MohammedAshikM3003/Cynexis/Esp32 Pins/WhatsApp Image 2026-10-05 at 19.05.23.jpeg

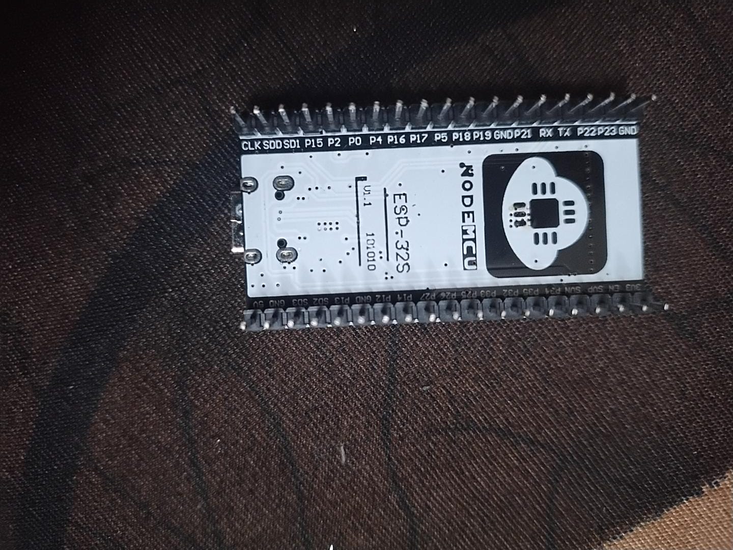
Esp32 Pins/WhatsApp Image 2026-10-05 at 19.05.23.jpeg
