MohammedAshikM3003/Cynexis/intro video/1bd78f29-dfb3-4b49-ac60-cee5ba025ea2.jpg

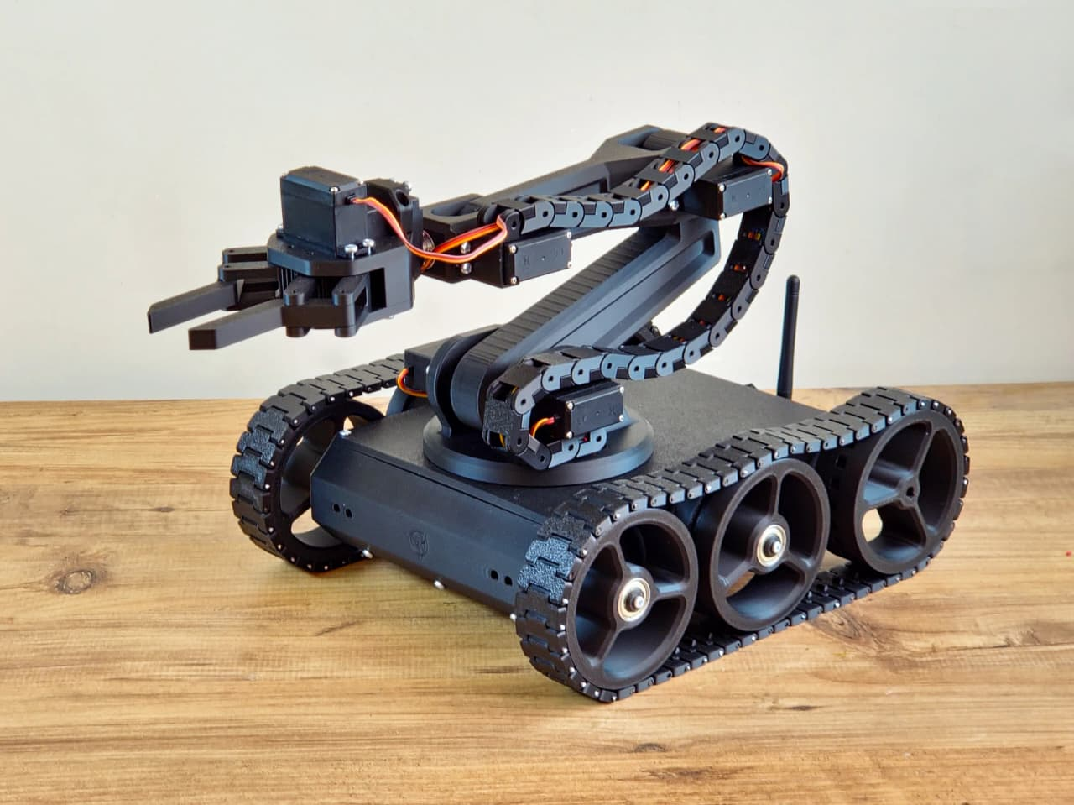
intro video/1bd78f29-dfb3-4b49-ac60-cee5ba025ea2.jpg
