MohammedAshikM3003/Cynexis/CYNEXIS_MASTER_SPECIFICATION.md

# CYNEXIS — Master Specification v2.1
> **Single Source of Truth. Do not contradict this document.**
> Version: 2.1 | Date: 2026-08-04 | Status: Active | Engineer: Mohammed Ashik M

---

## 1. PROJECT IDENTITY

| Field | Value |
|---|---|
| **Name** | CYNEXIS |
| **Tagline** | Connecting Human Intelligence with Machine Precision |
| **Version** | 2.1 (specification) / 1.0 (build) |
| **Type** | AI-Powered Gesture-Controlled Robotic Platform |
| **Status** | Phase 0 Complete — Phase 1 Starting |

---

## 2. WHAT WAS REMOVED (V1 → V2)

These features existed in the old concept. They are **permanently removed**.

| Feature | Reason |
|---|---|
| **Standalone voice-control mode** | Removed — no keyword-trigger-only commands |
| Holographic module | Out of scope |
| MongoDB | Replaced by SQLite + ChromaDB |
| MQTT | Replaced by ESP-NOW + Wi-Fi |
| TensorFlow | Replaced by PyTorch + YOLOv8 |

> **Clarification:** *AI-assisted voice interaction is retained.* The INMP441 microphone, MAX98357A amplifier, and speaker are part of the status glove and support two-way AI conversation. What is removed is the old standalone voice-command-only control mode from V1.

> **Rule:** Do not re-add any of these without a critical engineering justification.

---

## 3. SYSTEM ARCHITECTURE

```
                    LAPTOP AI CORE
                          │
              OpenCV + YOLO + MediaPipe
              PyTorch + FastAPI + ChromaDB
                          │
                        Wi-Fi
                          │
        ┌─────────────────┴─────────────────┐
        │                                   │
  CONTROL GLOVE                       ROBOT ESP32
        │                                   │
     ESP-NOW                           BTS7960
        │                              PCA9685
  5x Flex sensors                    4x DC motors
  MPU6050 IMU                        4x DS3218 servos
  ESP32                              HC-SR04
                                     Voltage sensor
                                     E-stop
        └─────────────────┬─────────────────┘
                          │ ESP-NOW
                    STATUS GLOVE
                          │
                    CYNEXIS OS
                          │
              3.5" Capacitive touchscreen
              INMP441 microphone
              MAX98357A + speaker
              Vibration motor
              ESP32
```

---

## 4. BILL OF MATERIALS (v2.0 OFFICIAL)

### 4.1 Control Glove

| ID | Component | Qty | Specs |
|----|---|-----|---|
| CG01 | ESP32 Dev Module | 1 | 38-pin WROOM-32 |
| CG02 | Flex Sensor 2.2" | 5 | 10k-110k Ω |
| CG03 | MPU6050 IMU | 1 | I2C, 3.3V |
| CG04 | 18650 Li-ion Cell | 1-2 | 2500-3500 mAh |
| CG05 | TP4056 Type-C Module | 1 | 1A, with protection |
| CG06 | Power Switch SPST | 1 | ≥5A rated |
| CG07 | Cotton Glove | 1 | Size L |

### 4.2 Status Glove

> **Two-stage build. Do not attempt Stage B until Stage A is fully tested.**

#### Stage A — Build First

| ID | Component | Qty | Specs |
|----|---|-----|---|
| SG01 | ESP32 Dev Module | 1 | 38-pin WROOM-32 |
| SG02 | 3.5" Capacitive Touchscreen | 1 | ILI9488 or similar, SPI |
| SG03 | Vibration Motor | 1 | 3V coin-type |
| SG04 | 2N2222 Transistor | 1 | NPN, TO-92 (for motor drive) |
| SG05 | 18650 Li-ion Cell | 1-2 | 2500-3500 mAh |
| SG06 | TP4056 Type-C Module | 1 | 1A, with protection |
| SG07 | Power Switch SPST | 1 | ≥5A rated |
| SG08 | Cotton Glove | 1 | Size L |

**Stage A goal:** CYNEXIS OS boots, touchscreen responds, vibration feedback works, ESP-NOW link active.

#### Stage B — Add After Stage A Complete

| ID | Component | Qty | Specs |
|----|---|-----|---|
| SG09 | INMP441 Microphone | 1 | I2S, 3.3V |
| SG10 | MAX98357A Amplifier | 1 | I2S, 3W |
| SG11 | Speaker | 1 | 3W, 4Ω or 8Ω |

**Stage B goal:** AI voice interaction, waveform display, audio feedback active.

### 4.3 Robot Platform

| ID | Component | Qty | Specs |
|----|---|-----|---|
| RB01 | ESP32 Dev Module | 1 | 38-pin WROOM-32 |
| RB02 | BTS7960 Motor Driver | 1 | 43A peak, 12V |
| RB03 | PCA9685 Servo Driver | 1 | 16-ch, I2C, 50Hz |
| RB04 | DC Gear Motor 12V | 4 | 150-300 RPM, metal gear |
| RB05 | DS3218 Servo Motor | 4 | 20kg-cm, 270° |
| RB06 | HC-SR04 Ultrasonic | 1 | 2-400cm |
| RB07 | Aluminium 4WD Chassis | 1 | Full kit |
| RB08 | 4-DOF Aluminium Arm | 1 | Compatible with DS3218 |
| RB09 | 18650 Li-ion Cell | 3 | 3S pack, 2500-3500 mAh |
| RB10 | BMS 3S | 1 | 10A, overcharge protection |
| RB11 | LM2596 Buck Converter | 2 | Adjustable, 3A |
| RB12 | XT60 Connector | 2 | Male + Female pair |
| RB13 | 10A Fuse + Holder | 1 | Inline blade type |
| RB14 | E-stop Button | 1 | NC momentary, red |
| RB15 | Power Switch | 1 | SPST ≥5A |
| RB16 | Heatsink | 2 | For BTS7960 + LM2596 |
| RB17 | TVS Diode 15V | 2 | DO-15 |
| RB18 | 1N4007 Diode | 10 | Flyback protection |
| RB19 | 1000µF 25V Capacitor | 4 | Electrolytic |
| RB20 | 470µF 16V Capacitor | 4 | Electrolytic |
| RB21 | INA219 Current/Voltage Sensor | 1 | I2C, measures current + power + battery runtime |

### 4.4 Vision System

| ID | Component | Qty | Specs |
|----|---|-----|---|
| VS01 | Dedicated Camera Module | 1 | 1080p, low-latency stream, compact rover front mount |
| VS02 | White LED Illumination | 1-2 | Software-controllable front LED flash/light |

### 4.5 Prototyping (shared)

| ID | Component | Qty |
|----|---|-----|
| PR01 | Breadboard (full size) | 2 |
| PR02 | Jumper wire sets (M-M, M-F, F-F) | 3 sets |
| PR03 | Resistor kit (assorted, incl. 10kΩ) | 1 kit |
| PR04 | Capacitor kit (assorted) | 1 kit |
| PR05 | LED pack | 1 pack |
| PR06 | 2N2222 NPN transistor | 4 |
| PR07 | Male header pins | 2 packs |
| PR08 | Female header pins | 2 packs |
| PR09 | Heat-shrink tubing | 1 pack |
| PR10 | Electrical tape | 1 roll |
| PR11 | Zip ties | 1 pack |

> **Note on MG996R vs DS3218:** Architecture upgraded from MG996R (10kg-cm) to DS3218 (20kg-cm, 270°) for the robotic arm. DS3218 provides stronger hold and wider angle range.

---

## 5. CYNEXIS OS

### 5.1 Overview

CYNEXIS OS is a full graphical interface running on the status glove's 3.5" touchscreen. It is implemented using **LVGL** (Light and Versatile Graphics Library).

### 5.2 Screens

| Screen | Function |
|---|---|
| Boot screen | Animated CYNEXIS startup logo |
| Diagnostics | Real-time sensor health, battery, signal |
| AI Assistant | Voice + text AI interaction |
| Gesture Monitor | Live finger and IMU data display |
| Communication | ESP-NOW / Wi-Fi link status |
| Settings | Brightness, volume, thresholds |
| Camera | Live feed from robot camera |
| Arm Control | Manual servo position control |
| Battery Monitor | Voltage, current, runtime estimate |
| Sensor Monitor | All sensor values in real time |
| Audio Interface | Waveform, voice input, speaker |
| Notifications | Alerts, warnings, system messages |

### 5.3 UI Features

- Animated icons
- Dark mode
- Sliding menus
- Touch control (capacitive)
- Real-time telemetry overlay
- Waveform display
- Voice feedback via speaker

### 5.4 Implementation

- Library: **LVGL v9.x**
- Design tool: **Figma** (mockups)
- Target: ESP32 with ILI9488 3.5" display
- Communication to robot: ESP-NOW (status updates)
- Communication to laptop: Wi-Fi (AI assistant)

---

## 6. SOFTWARE STACK

### 6.1 Embedded

| Tool | Purpose |
|---|---|
| Arduino IDE 2.3.10 | Flashing, library management |
| PlatformIO v3.3.4 | Advanced build system |
| ESP-IDF | Low-level ESP32 APIs |
| FreeRTOS | Task scheduling on ESP32 |
| LVGL v9.x | CYNEXIS OS UI framework |

### 6.2 AI / Vision

| Library | Version | Purpose |
|---|---|---|
| Python | 3.12.10 | Runtime (venv at d:\Cynexis\.venv) |
| PyTorch | 2.13.0 | AI/ML framework |
| OpenCV | 5.0.0.93 | Computer vision |
| MediaPipe | 1.0.0 | Hand/pose tracking |
| Ultralytics (YOLOv8) | 8.4.115 | Object detection |
| DeepSORT | latest | Object tracking |

### 6.3 Backend

| Tool | Version | Purpose |
|---|---|---|
| FastAPI | 0.141.1 | REST API server |
| Uvicorn | 0.52.1 | ASGI server |
| WebSockets | 17.0.1 | Real-time data |

### 6.4 Frontend

| Tool | Purpose |
|---|---|
| React | Web dashboard |
| Figma | UI design and mockups |

### 6.5 Database / Memory

| System | Purpose |
|---|---|
| SQLite | Short-term memory, session context |
| ChromaDB | Long-term vector memory, retrieval |

---

## 7. COMMUNICATION ARCHITECTURE

| Link | Protocol | Speed | Notes |
|---|---|---|---|
| Control glove → Robot | ESP-NOW | ~50 Hz | <1ms latency, no router needed |
| Robot → Status glove | ESP-NOW | ~10 Hz | Status + ACK |
| Robot → Laptop | Wi-Fi | As needed | Telemetry + camera |
| Laptop → Robot | Wi-Fi | As needed | AI commands |

---

## 8. DEVELOPMENT PHASES

| Phase | Name | Key Deliverables |
|---|---|---|
| 0 | Environment Setup | ✅ Complete |
| 1 | Control Glove | Flex + IMU + ESP-NOW TX |
| 2 | Status Glove | OLED/Touch + CYNEXIS OS boot |
| 3 | Robot Base | Motors + BTS7960 + ESP-NOW RX |
| 4 | Robotic Arm | DS3218 servos + PCA9685 |
| 5 | Vision System | Camera + OpenCV + YOLOv8 |
| 6 | Audio System | INMP441 + MAX98357A + voice |
| 7 | CYNEXIS OS | Full LVGL UI on touchscreen |
| 8 | Full Integration | All systems unified + testing |

---

## 9. POWER ARCHITECTURE

### Robot (3S Li-ion, 11.1V)

```
3S Battery Pack (11.1V)
        │
      [BMS 10A]
        │
     [10A Fuse]
        │
   [Main Switch]
        │
        ├── [BTS7960] ──── 4× DC Motors (12V direct)
        │
        ├── [LM2596 #1] ── 6.5V ── [PCA9685 V+] ── 4× DS3218 servos
        │                   ↑
        │          (NOT 7.5V — reduces heating, improves reliability)
        │
        └── [LM2596 #2] ── 5V ─── [ESP32 VIN]
                                ├── [HC-SR04]
                                └── [PCA9685 VCC]
```

> **Servo voltage note:** DS3218 rated for 4.8V–8.4V. Running at 6.5V is the optimal point — high enough for torque, low enough to minimize heat and extend servo lifespan. Never exceed 7.5V under continuous load.

### Gloves (Single cell, 3.7V)

```
18650 Cell → [TP4056] → ESP32 + sensors
```

---

## 10. CAMERA & VISION SYSTEM ARCHITECTURE

### 10.1 Overview & Purpose
The camera system acts as the **visual sensor ("eyes") for the Cynexis Agent**, streaming live video, capturing photographs, uploading to cloud storage, and providing visual data to AI vision models (VLM) and the Cynexis Web Dashboard.

```
                    ┌──────────────────────────┐
                    │       CYNEXIS AGENT      │
                    │                          │
                    │  Vision / AI Processing  │
                    └────────────┬─────────────┘
                                 │
                         Commands / Analysis
                                 │
                                 ▼
┌────────────────────────────────────────────────────────────┐
│                     CYNEXIS ROVER                          │
│                                                            │
│   ┌──────────────┐       ┌─────────────────────────────┐  │
│   │ Camera       │──────▶│ Camera Controller           │  │
│   │ Module       │       │                             │  │
│   └──────────────┘       │ Capture / Stream / Control  │  │
│          │               └──────────────┬──────────────┘  │
│          │                              │                 │
│          ▼                              ▼                 │
│   ┌──────────────┐              ┌───────────────┐        │
│   │ LED / Light  │              │ Rover Network │        │
│   └──────────────┘              └───────┬───────┘        │
│                                         │                 │
└─────────────────────────────────────────┼─────────────────┘
                                          │
                                          ▼
                              ┌──────────────────────┐
                              │   Internet / Cloud   │
                              └──────────┬───────────┘
                                         │
                         ┌───────────────┴──────────────┐
                         ▼                              ▼
                 ┌───────────────┐              ┌──────────────┐
                 │ Image Storage │              │ Cynexis Web  │
                 │ / Database    │              │ Dashboard    │
                 └───────────────┘              └──────────────┘
```

### 10.2 Key Architectural Decisions
1. **Cloud-Primary Image Repository**: Captured images are uploaded directly to Cloud Object Storage, while metadata (timestamp, GPS lat/long, camera_id, file/thumbnail URL, AI status) is indexed in the Database.
2. **Optional microSD / Offline Buffer**: Permanent image storage resides in the cloud. Local storage is used strictly as a temporary buffer when network connectivity is offline, uploading automatically when connection restores.
3. **Controllable Illumination**: Dedicated controllable front White LED light system paired with the camera module for low-light navigation.
4. **Mechanical Clearance**: Mounted at the front of the rover below and clear of the 4-DOF robotic arm to prevent view obstruction, mechanical collision, or GPS interference.
5. **Three Visual Data Tiers**:
   - **Live Video Feed**: Temporary low-latency stream for live dashboard viewing.
   - **Captured Photographs**: Stored permanently in Cloud Storage with metadata index.
   - **AI Vision Frames**: Specific frames dispatched to the AI Vision VLM pipeline for agent scene analysis.

### 10.3 Vision Pipeline

```
[Robot] ── USB / Wi-Fi Cable ──► [Camera Controller]
                                         │
                                   OpenCV (capture)
                                         │
                             ┌───────────┴───────────┐
                             │                       │
                        MediaPipe                  YOLO
                      (hand/pose)            (object detect)
                             │                       │
                         DeepSORT              FastAPI server
                      (tracking)                     │
                             └───────────┬───────────┘
                                         │
                                  Cloud / Web / AI
                                         │
                                   Cynexis Agent
```

> Camera transport ensures low latency for real-time visual teleoperation while providing on-demand capture dispatches to Cloud Storage and the local VLM engine.

---

## 11. THERMAL MANAGEMENT

| Component | Risk | Mitigation |
|---|---|---|
| BTS7960 | High heat under load (43A peak) | Heatsink mandatory + 30mm fan on chassis |
| LM2596 #1 (6.5V) | Moderate heat (12V→6.5V, 5.5V drop × current) | Heatsink + airflow slot on chassis |
| LM2596 #2 (5V) | Low-moderate heat | Heatsink |
| DS3218 servos | Heat under stall load | Monitor via telemetry; add rest intervals in firmware |
| ESP32 | Low — 250mW max | No heatsink needed |

### Chassis Design Requirements
- Minimum 2 vent holes on chassis sides (≥20mm diameter)
- 30mm 5V brushless fan mounted over BTS7960
- Airflow path: front intake → BTS7960 + LM2596 → rear exhaust
- Future: servo temperature monitoring via NTC thermistor on PCA9685 aux channel

---

## 12. SYSTEM STATE MACHINE

The robot operates in one of these exclusive states at all times:

| State | Description | Entry Condition | Exit Condition |
|---|---|---|---|
| `NORMAL` | Full operation, all systems active | Boot complete + link established | Any trigger below |
| `IDLE` | No glove input for >5s, motors stopped | Timeout from NORMAL | Any glove input |
| `MANUAL` | Direct gesture control, no AI | User selects on CYNEXIS OS | Mode switch |
| `AI` | AI controls robot, glove monitors only | User selects on CYNEXIS OS | Mode switch |
| `SAFE` | Reduced speed, obstacle avoidance active | HC-SR04 <30cm | Obstacle cleared |
| `EMERGENCY` | All motors cut immediately | E-stop button OR FIST gesture >2s | Manual reset only |
| `SHUTDOWN` | Graceful power-off sequence | Battery <10% OR user command | Power cycle |

> **Rule:** `EMERGENCY` state can only be exited by a manual hardware reset. It cannot be cleared by software.

---

## 13. COMMUNICATION PACKET DEFINITION

### Control Packet (Glove → Robot, 50 Hz, 24 bytes)

| Field | Type | Bytes | Description |
|---|---|---|---|
| `timestamp` | uint32 | 4 | Milliseconds since boot |
| `finger[5]` | uint16×5 | 10 | ADC values: thumb, index, middle, ring, pinky |
| `roll` | int16 | 2 | MPU6050 roll · 100 (degrees ×100) |
| `pitch` | int16 | 2 | MPU6050 pitch · 100 |
| `battery` | uint8 | 1 | Glove battery % (0–100) |
| `flags` | uint8 | 1 | Bit 0: E-stop, Bit 1: gesture lock, Bits 2-7: reserved |
| `checksum` | uint16 | 2 | CRC16 of above bytes |

### Status Packet (Robot → Status Glove, 10 Hz, 20 bytes)

| Field | Type | Bytes | Description |
|---|---|---|---|
| `timestamp` | uint32 | 4 | Milliseconds since boot |
| `battery_mv` | uint16 | 2 | Robot battery millivolts (INA219) |
| `current_ma` | uint16 | 2 | Robot current draw milliamps (INA219) |
| `distance_cm` | uint16 | 2 | HC-SR04 distance in cm |
| `rssi` | int8 | 1 | ESP-NOW signal strength (dBm) |
| `mode` | uint8 | 1 | System state: NORMAL/IDLE/MANUAL/AI/SAFE/EMERGENCY/SHUTDOWN |
| `errors` | uint8 | 1 | Bit flags: motor fault, servo fault, sensor fault, etc. |
| `temperature` | uint8 | 1 | Chassis temperature °C (future: NTC thermistor) |
| `checksum` | uint16 | 2 | CRC16 of above bytes |
| `reserved` | uint8×4 | 4 | For future expansion |

---

## 14. FOUR DOCUMENTS RULE

When any change is made to the project, update **only these four files**:

| File | Purpose |
|---|---|
| `CYNEXIS_MASTER_SPECIFICATION.md` | Single source of truth (this file) |
| `CYNEXIS_Development_Notebook.md` | Daily log, errors, decisions |
| `Hardware_Shopping_Guide.md` | Phased BOM with prices |
| `CHANGELOG.md` | Version history of all changes |

---

## 15. AI TOOL WORKFLOW

| Tool | Use For |
|---|---|
| **Antigravity IDE** | All code editing, git, terminal |
| **ChatGPT** | Brainstorming, architecture reviews, planning |
| **Claude** | Long code generation, firmware, large file analysis |
| **GitHub** | Version control at github.com/MohammedAshikM3003/Cynexis |

---

## 16. ARCHITECTURE RULES

1. **Never change the architecture without a critical reason and explanation**
2. **Always estimate cost, power, risks, and reliability for any new component**
3. **Always think from the perspective of all engineering disciplines**
4. **Removed features stay removed unless there is a critical reason**
5. **Build phase by phase — do not skip phases**
6. **Test each phase before proceeding to the next**

---

*CYNEXIS Master Specification v2.1 — Architecture frozen. Build Phase 1 now.*
