MohammedAshikM3003/Cynexis/Research Papers/CYNEXIS_Implementation_Plan.docx

# CYNEXIS Pro – Implementation, Budget, Hardware and Software Plan

# 1. Weekly Implementation Plan

Week | Tasks
Week 1 | Finalize scope, architecture, logo, documentation
Week 2 | Purchase components and create repository
Week 3 | Build neural glove and calibrate sensors
Week 4 | Develop ESP32 communication module
Week 5 | Assemble robotic arm
Week 6 | Integrate motors, wheels, and chassis
Week 7 | Implement OpenCV and object detection
Week 8 | Implement voice control
Week 9 | Integrate AI modules
Week 10 | Build holographic module
Week 11 | Testing and optimization
Week 12 | Documentation and presentation

# 2. Hardware Requirements

Component | Quantity | Cost
ESP32 | 1 | ₹500
MPU6050 | 1 | ₹200
Flex sensors | 5 | ₹1500
Servo motors | 6 | ₹3000
L298N motor driver | 1 | ₹300
DC motors | 4 | ₹800
Wheels | 4 | ₹500
Chassis | 1 | ₹1000
Camera | 1 | ₹2000
Battery pack | 1 | ₹1000
Acrylic sheet | 1 | ₹500
Wires/connectors | Multiple | ₹800

# 3. Software Requirements

- Python
- OpenCV
- TensorFlow
- FastAPI
- React
- MongoDB
- MQTT
- GitHub
- VS Code
- Arduino IDE

# 4. Budget Allocation

Module | Budget
Neural glove | ₹2500
Robotic arm | ₹5000
Mobile platform | ₹4000
AI module | ₹2000
Holographic module | ₹1500
Miscellaneous | ₹5000
Total | ₹24000

# 5. Recommended Development Order

1. Glove
2. Robotic arm
3. Wheels and motors
4. AI integration
5. Holographic module
6. Final testing
