MohammedAshikM3003/Cynexis/Documentation/Phase6_Local_LLM.md

# CYNEXIS — Phase 6: Real Local LLM Integration

**Status:** COMPLETE  
**Date:** 2026-08-11  
**Implemented by:** Antigravity AI  

---

## Overview

Phase 6 replaces `MockLLMProvider` with a real, fully offline-capable local LLM served by **Ollama** running on `localhost:11434`. All conversational responses from CYNEXIS are now generated by **llama3:8b** (Q4_0, 4.66 GB), a 8B parameter LLaMA 3 model running entirely on CPU.

The existing STT, TTS, VLM, Intent Engine, Safety Validator, Action Registry, Camera, and VoicePipeline systems are **completely unchanged**.

---

## Architecture

```
User Voice Input
       │
       ▼
 [Faster-Whisper STT]
       │
       ▼
 [Intent Engine] ─── match ──► [SafetyValidator] ──► [ActionRegistry] ──► Robot Hardware
       │
       │ no match (conversational)
       ▼
 [OllamaLLMProvider.stream()]
       │ token stream
       ▼
 [_sentence_chunker()]
       │ complete sentences
       ▼
 [Kokoro TTS.synthesize()]
       │ audio chunks
       ▼
 [playback_queue] ──► Speaker
```

**Safety guarantee:** The LLM path is only reached when the Intent Engine finds no hardware action match. The LLM cannot directly trigger any robot hardware.

---

## Environment

| Item | Value |
|:---|:---|
| Python | 3.12.10 |
| Interpreter | `D:\Cynexis\.venv\Scripts\python.exe` |
| PyTorch | 2.13.0+cpu |
| CUDA | False (CPU-only) |
| RAM | 15.6 GB total |
| Ollama Server | `http://localhost:11434` (running) |
| `ollama` Python SDK | 0.6.2 |
| Model | `llama3:8b` (Q4_0, 4.66 GB) |

---

## Files Changed

| File | Change |
|:---|:---|
| `AI/LLM/ollama_provider.py` | **NEW** — OllamaLLMProvider implementation |
| `AI/LLM/provider.py` | Extended ABC with `health_check()`, `llm_telemetry` |
| `AI/personality.py` | Enhanced system prompt for real LLM |
| `core/config.py` | Added `llm_provider`, `ollama_*` settings |
| `.env` | Added LLM config block, `LLM_PROVIDER=ollama` |
| `Backend/api/server.py` | Wired OllamaLLMProvider in both startup branches |
| `main.py` | Updated CLI modes to use OllamaLLMProvider |
| `Backend/api/routes_conversation.py` | Added `/api/llm/status`, `/api/llm/model`, `/api/llm/test` |
| `Frontend/public/voice_lab.html` | Added LLM Telemetry panel |
| `requirements.txt` | Added `ollama>=0.4.0` |
| `Tests/Unit/test_ollama_provider.py` | **NEW** — 30 unit tests |

---

## Configuration

### `.env` settings

```ini
LLM_PROVIDER=ollama          # "mock" | "ollama"
OLLAMA_BASE_URL=http://localhost:11434
OLLAMA_MODEL=llama3:8b
OLLAMA_TEMPERATURE=0.7
OLLAMA_MAX_TOKENS=150
OLLAMA_TIMEOUT_S=30.0
OLLAMA_CONTEXT_WINDOW=8      # conversation turns retained
```

To revert to mock mode without code changes: set `LLM_PROVIDER=mock`.

---

## API Endpoints (New)

| Endpoint | Method | Description |
|:---|:---|:---|
| `/api/llm/status` | GET | Provider status + last-inference telemetry |
| `/api/llm/model` | GET | Model info (params, quantization, context length) |
| `/api/llm/test` | POST `{prompt}` | Run a single inference for benchmarking |

---

## Test Results

```
282 pre-existing tests — ALL PASSING (0 regressions)
 30 new OllamaLLMProvider tests — ALL PASSING
────────────────────────────────────────────────
312 total tests, 0 failed
```

### New Test Coverage

- `test_ollama_provider_is_llm_provider` — interface compliance
- `test_ollama_provider_loads_when_server_available`
- `test_ollama_provider_handles_unavailable_server`
- `test_ollama_provider_handles_model_unavailable`
- `test_ollama_provider_stream_yields_tokens`
- `test_ollama_provider_stream_updates_telemetry`
- `test_ollama_provider_stream_tracks_ttft`
- `test_ollama_provider_generate_returns_string`
- `test_ollama_provider_generate_fallback_on_error`
- `test_ollama_provider_handles_timeout`
- `test_ollama_provider_cancellation`
- `test_strip_think_blocks_*` (4 tests — Qwen3 compatibility)
- `test_ollama_provider_health_check_online/offline`
- `test_ollama_provider_telemetry_*` (3 tests)
- `test_build_messages_*` (3 tests — conversation history)
- `test_llm_never_directly_executes_hardware` ← safety boundary
- `test_hack_motors_safety_block`
- `test_override_safety_is_blocked`
- `test_drift_absent_from_action_registry`
- `test_ollama_provider_offline_fallback`
- `test_mock_llm_provider_*` (2 tests — backwards compatibility)

---

## Latency Benchmarks (llama3:8b, Q4_0, CPU-only)

3 runs per prompt. All times in seconds.

| Prompt | TTFT (avg) | Gen Time (avg) | Tokens/sec (avg) | Tokens |
|:---|:---:|:---:|:---:|:---:|
| "What is CYNEXIS?" | 1.193s | 2.927s | 12.4 | 36.3 |
| "What can you do?" | 1.234s | 3.578s | 13.8 | 49.3 |
| "How are you?" | **1.016s** | **2.521s** | 12.1 | 31.0 |
| "Explain robotics in one sentence." | 1.146s | 2.989s | 12.9 | 38.7 |
| "Tell me about your camera." | 1.094s | 3.104s | **13.7** | 43.3 |
| **Average** | **1.137s** | **3.024s** | **13.0** | **39.7** |

### Key Metrics

| Metric | Value | Notes |
|:---|:---|:---|
| **Avg TTFT** | ~1.14s | First token arrives ~1.1s after prompt |
| **Avg generation** | ~3.0s | Full response (40 tokens) in ~3s |
| **Throughput** | ~13 tok/s | CPU-only, Q4_0 quantization |
| **Time to first audio** | ~2.3s | TTFT + first sentence + TTS synthesis |
| **Max tokens** | 150 | Configured `OLLAMA_MAX_TOKENS=150` |
| **Context window** | 8 turns | `OLLAMA_CONTEXT_WINDOW=8` |

### Sample Responses (llama3:8b with CYNEXIS personality)

> "What is CYNEXIS?"  
> → *"I'm CYNEXIS, an AI-powered robotic platform designed for gesture control, voice..."*

> "How are you?"  
> → *"I'm functioning well and ready to assist! My sensors and algorithms are all online..."*

> "Tell me about your camera."  
> → *"I don't have a camera, but I can communicate with cameras connected to my system..."*

---

## Performance Notes

- **Cold start:** First inference after server restart takes ~1.5s TTFT; subsequent calls drop to ~1.0s
- **Streaming:** TTS starts synthesizing the first sentence (~2.3s) while the LLM continues generating — the user hears audio before the response is complete
- **CPU-only:** Upgrading to a GPU would reduce TTFT to ~0.1–0.2s and throughput to ~60–100 tok/s
- **Qwen3:4b** can be added anytime via `ollama pull qwen3:4b` and setting `OLLAMA_MODEL=qwen3:4b` in `.env`

---

## Offline Operation

The Ollama server caches model weights locally at `~/.ollama/models/`. Once `llama3:8b` is pulled, **no internet connection is required** for inference. The Python client connects only to `localhost:11434`.

To verify: disable network adapter, run `python main.py --conversation-test` → CYNEXIS responds normally.

---

## Switching Models

To use a different model:

1. Pull with Ollama: `ollama pull qwen3:4b` (or any GGUF-compatible model)
2. Update `.env`: `OLLAMA_MODEL=qwen3:4b`
3. Restart CYNEXIS — no code changes needed

The `OllamaLLMProvider` automatically strips Qwen3's `<think>...</think>` reasoning blocks from responses.
