MohammedAshikM3003/Cynexis/Bills/day 1.jpeg

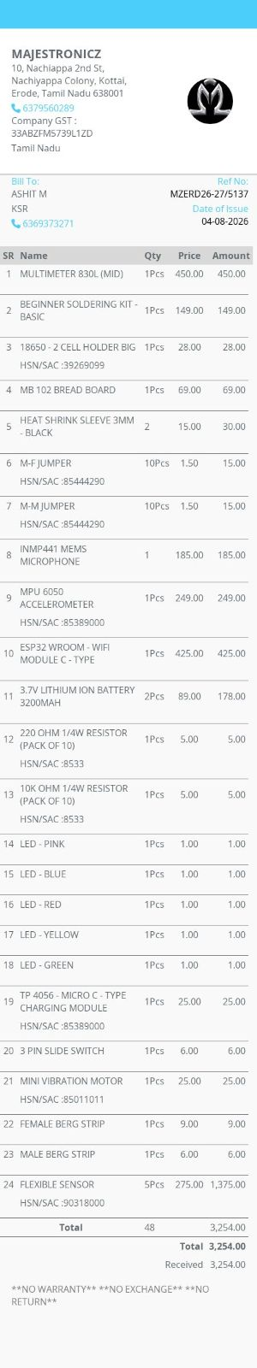
Bills/day 1.jpeg
