MohammedAshikM3003/Cynexis/Bills/day 2.jpeg

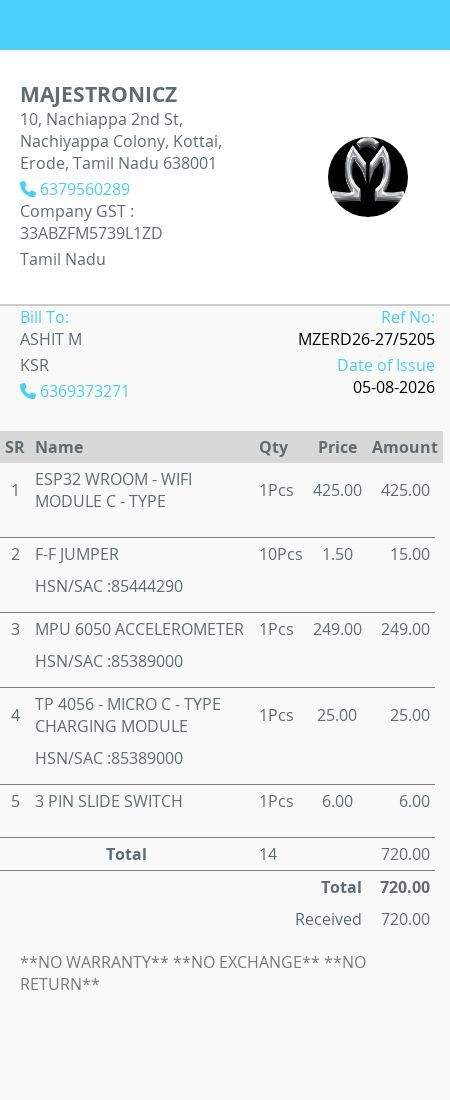
Bills/day 2.jpeg
