MohammedAshikM3003/Cynexis/Bills/day 3.jpeg

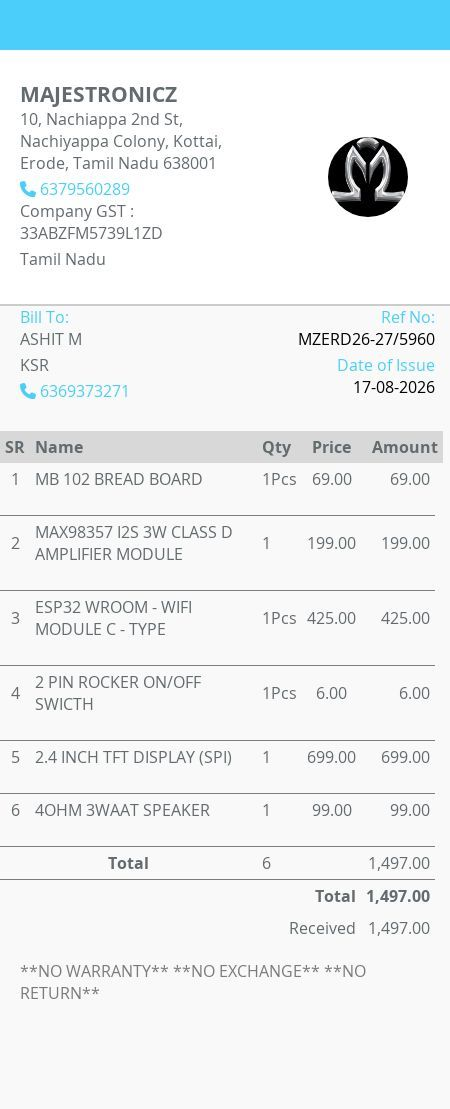
Bills/day 3.jpeg
