MohammedAshikM3003/Cynexis/Bills/day 4.jpeg

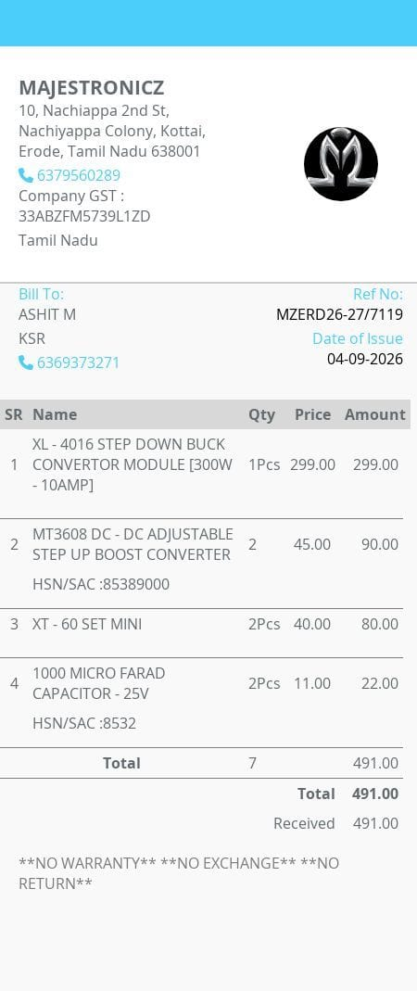
Bills/day 4.jpeg
