MohammedAshikM3003/Cynexis/Bills/day 5.jpeg

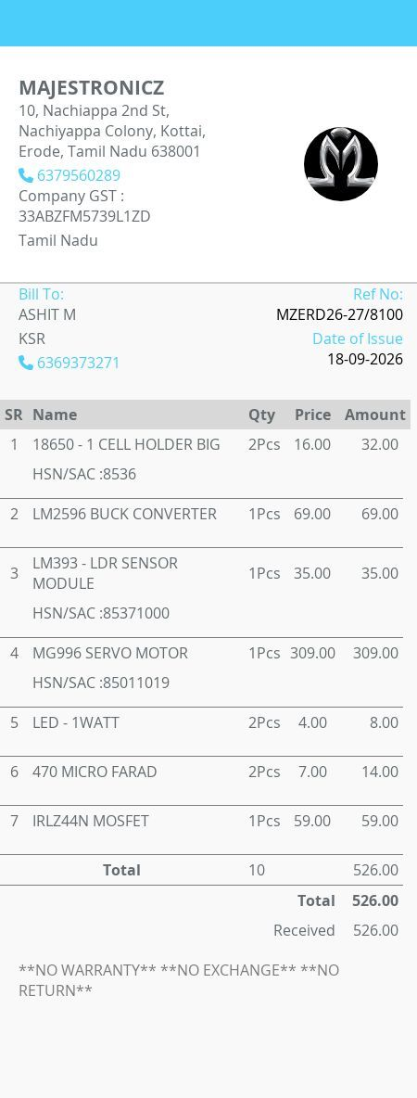
Bills/day 5.jpeg
