MohammedAshikM3003/Cynexis/Bills/day 6.jpeg

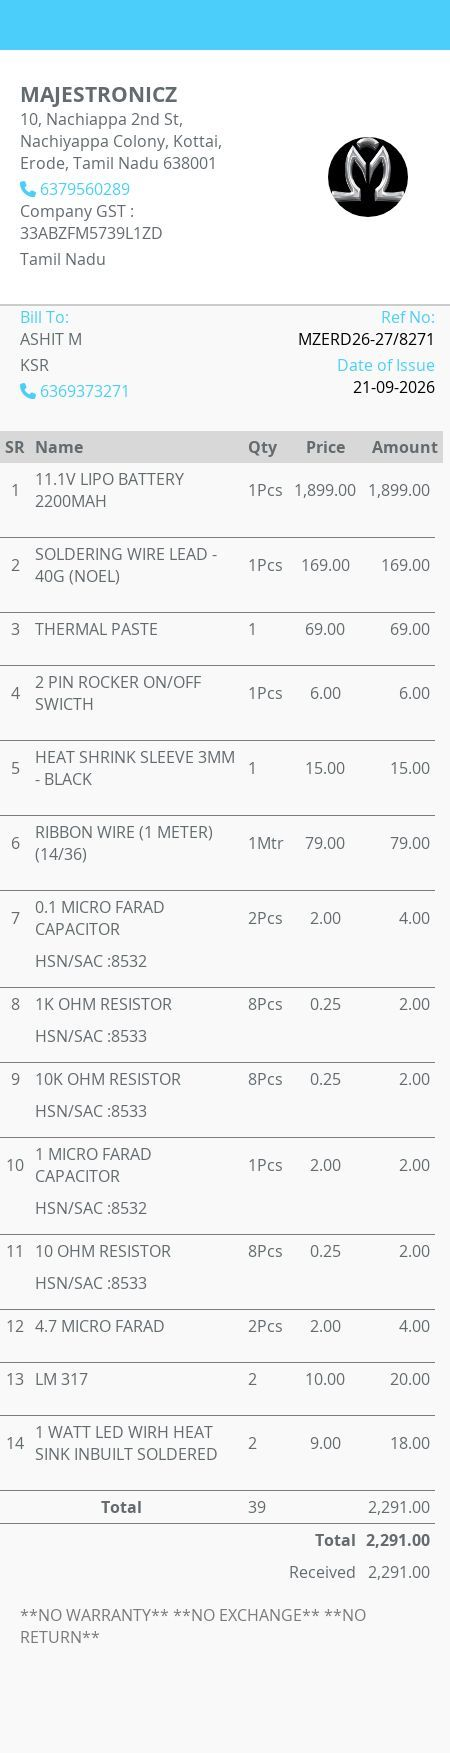
Bills/day 6.jpeg
