MohammedAshikM3003/Cynexis/Bills/day 7.jpeg

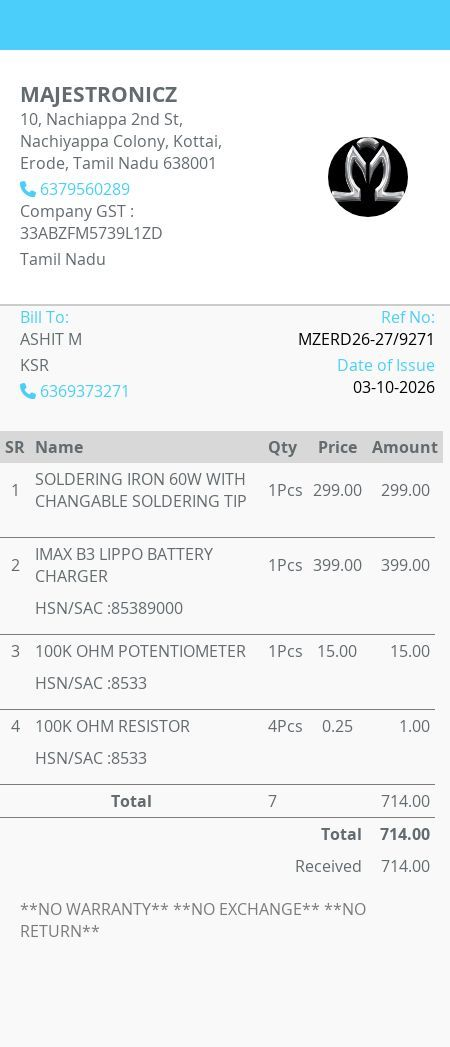
Bills/day 7.jpeg
