MohammedAshikM3003/Cynexis/Circuit Diagram/circuit_image.png

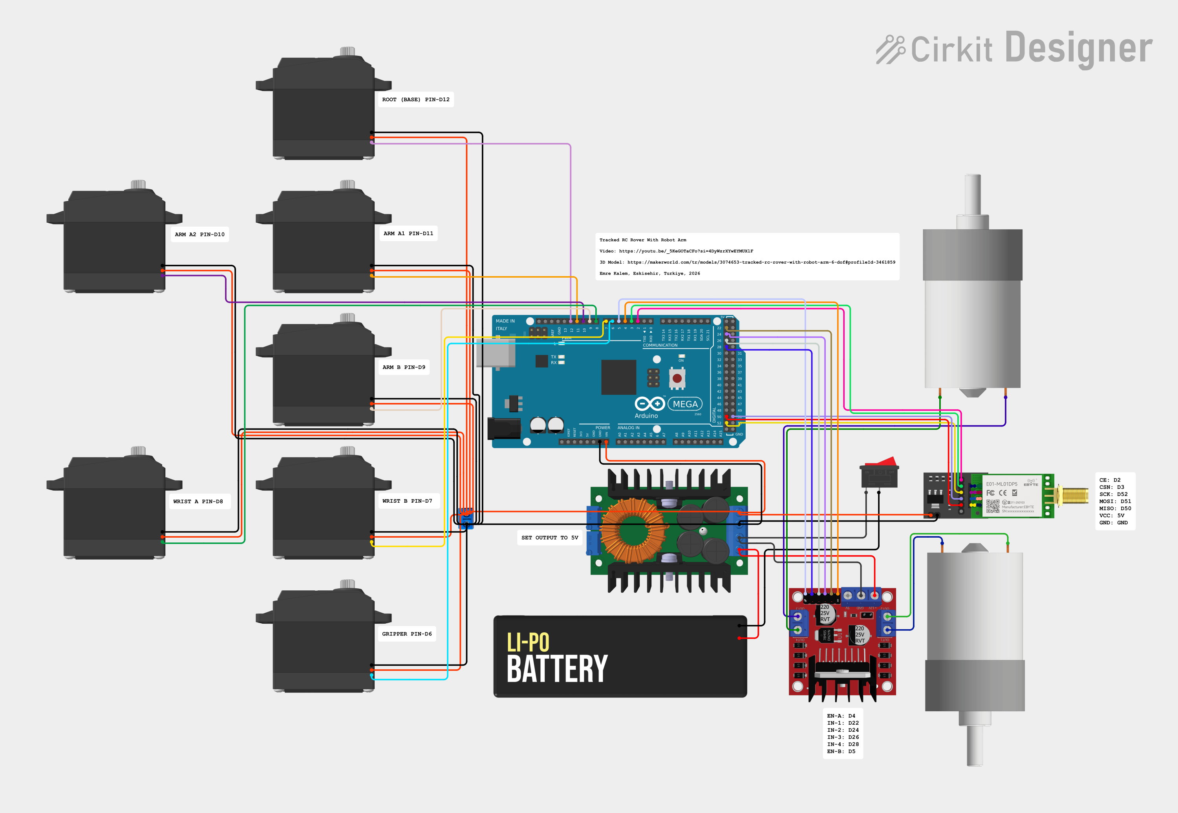
Circuit Diagram/circuit_image.png
