MohammedAshikM3003/Cynexis/Firmware/Display/cynexis_wallpaper_320x240.png

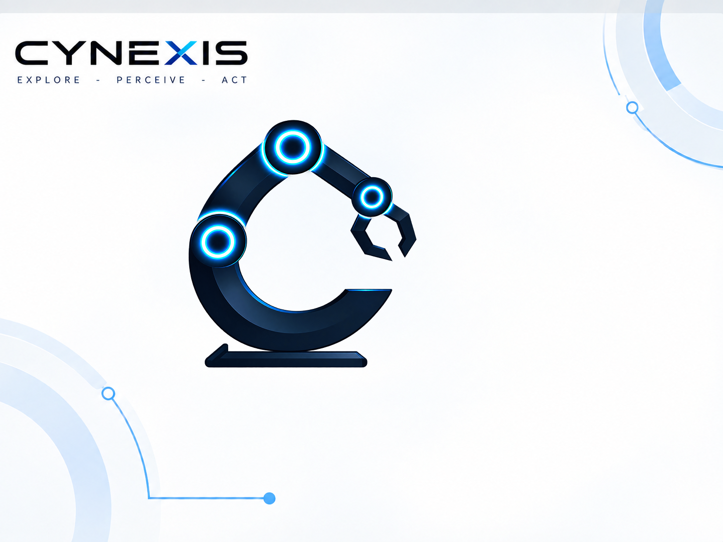
Firmware/Display/cynexis_wallpaper_320x240.png
