MohammedAshikM3003/Cynexis/intro video/33d2d60e-6721-4a0b-b365-824a473486ea.png

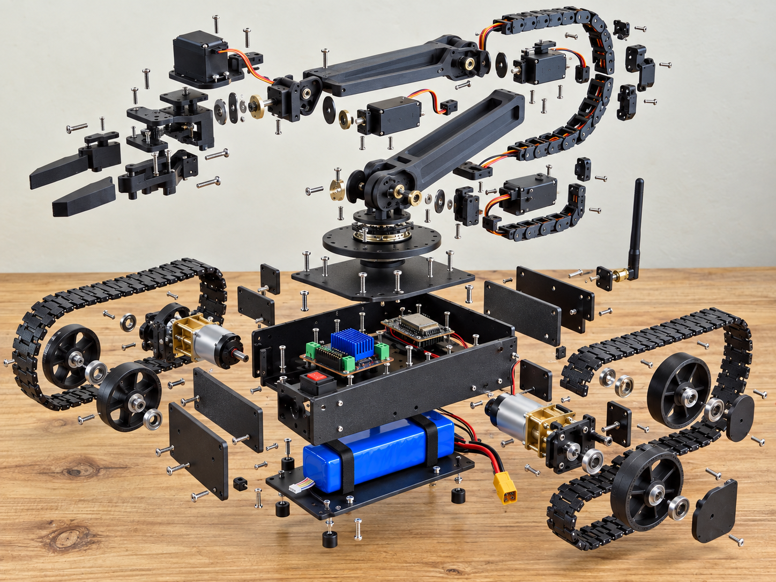
intro video/33d2d60e-6721-4a0b-b365-824a473486ea.png
