MohammedAshikM3003/Cynexis/Research Papers/ChatGPT Image Jul 30, 2026, 04_37_28 PM.png

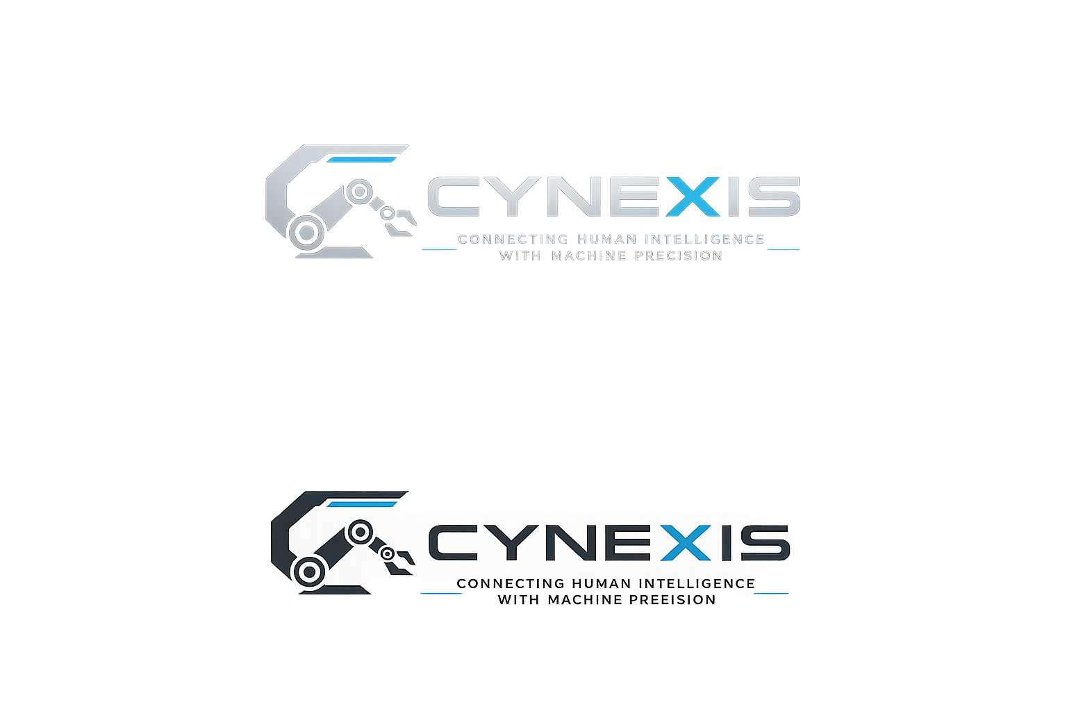
Research Papers/ChatGPT Image Jul 30, 2026, 04_37_28 PM.png
