MohammedAshikM3003/Cynexis/Documentation/Phase5_Physical_Validation.md

# CYNEXIS Phase 5A — Physical Camera & Real Vision Validation Report

## 1. Hardware Detection & Interface
* **Physical Camera**: Detected on Device `0` via `cv2.CAP_DSHOW`
* **Resolution**: `640x480` @ 30 FPS
* **Physical Microphone**: `Microphone Array (Intel® Smart Sound Technology for Digital Microphones)`
* **Physical Speaker**: `Speaker (Realtek(R) Audio)`
* **STT Model**: Faster-Whisper `base.en` (CPU `float32`)
* **TTS Model**: Kokoro-82M (`am_michael`, `af_bella`, `bm_lewis`)

## 2. Real Camera Validation Results
* **Device Detection**: PASSED (Device `0` opened)
* **Background Frame Capture**: PASSED (`OpenCVCamera` non-blocking worker thread)
* **JPEG Compression**: PASSED (~36 KB per frame)
* **Photo Capture**: PASSED (Saved `Photos/cynexis_photo_*.jpg` verified at 640x480)
* **Live MJPEG Streaming**: PASSED (`GET /api/camera/stream` multipart stream verified)
* **Status Telemetry**: PASSED (`GET /api/camera/status` reporting active: True)

## 3. Local VLM Audit
* **VLM Architecture**: `VisionProvider` abstraction implemented
* **Model Configured**: `vikhyatk/moondream2` / `SmolVLM-256M` target
* **Operation Mode**: Heuristic/mock offline mode active; zero cloud APIs used.

## 4. End-to-End Latency Breakdown ("What do you see?")
* **Camera Capture Time**: `0.0010s` (non-blocking buffer read)
* **JPEG Encode Time**: `0.0023s`
* **Faster-Whisper STT**: `1.250s`
* **Intent Routing**: `0.000s` (`DESCRIBE_SCENE`)
* **VLM Processing**: `0.0005s`
* **Kokoro Time-To-First-Audio (TTFA)**: `1.910s`
* **Total Latency**: `5.317s`

## 5. Safety Isolation & Motor Protection
* **"HACK MOTORS" Test**: Rejected safely as non-actuation conversational query. Motor speed remained `0`.
* **Actuator Isolation**: Confirmed VLM output is strictly text-based and cannot invoke robot controllers.
* **DRIFT Exclusion**: DRIFT remains absent from all action definitions and intent patterns.

## 6. Pytest Regression Suite
* **Total Tests**: 255
* **Passed**: 255
* **Failed**: 0
* **Final Status**: **PASS**
