MohammedAshikM3003/Cynexis/CYNEXIS_Voice_Pipeline_Test/index.html

CYNEXIS

Voice Pipeline Laboratory

READY

## 🎤 Voice Input

🎙

Click the microphone and speak.

Your speech will appear here…

🔊 Speak responseClear

CYNEXIS response

Ready. Ask me something.

## 🧠 Pipeline

MicrophoneAudio input

Speech-to-TextAudio → text

Intent EngineCommand / question classification

Action / AI ResponseMock CYNEXIS brain for this test

Text-to-SpeechText → laptop speaker

## Detected intent

—

## Try saying

“CYNEXIS, say hello to everyone”
“CYNEXIS, move forward”
“CYNEXIS, stop”
“What is your name?”
“What can you do?”
