MohammedAshikM3003/Cynexis/Schematics/Phase1_ControlGlove/CYNEXIS_Phase1_ControlGlove/CYNEXIS_Phase1_ControlGlove.kicad_sch

## KiCad design Schematics/Phase1_ControlGlove/CYNEXIS_Phase1_ControlGlove/CYNEXIS_Phase1_ControlGlove.kicad_sch (2026-08-12)

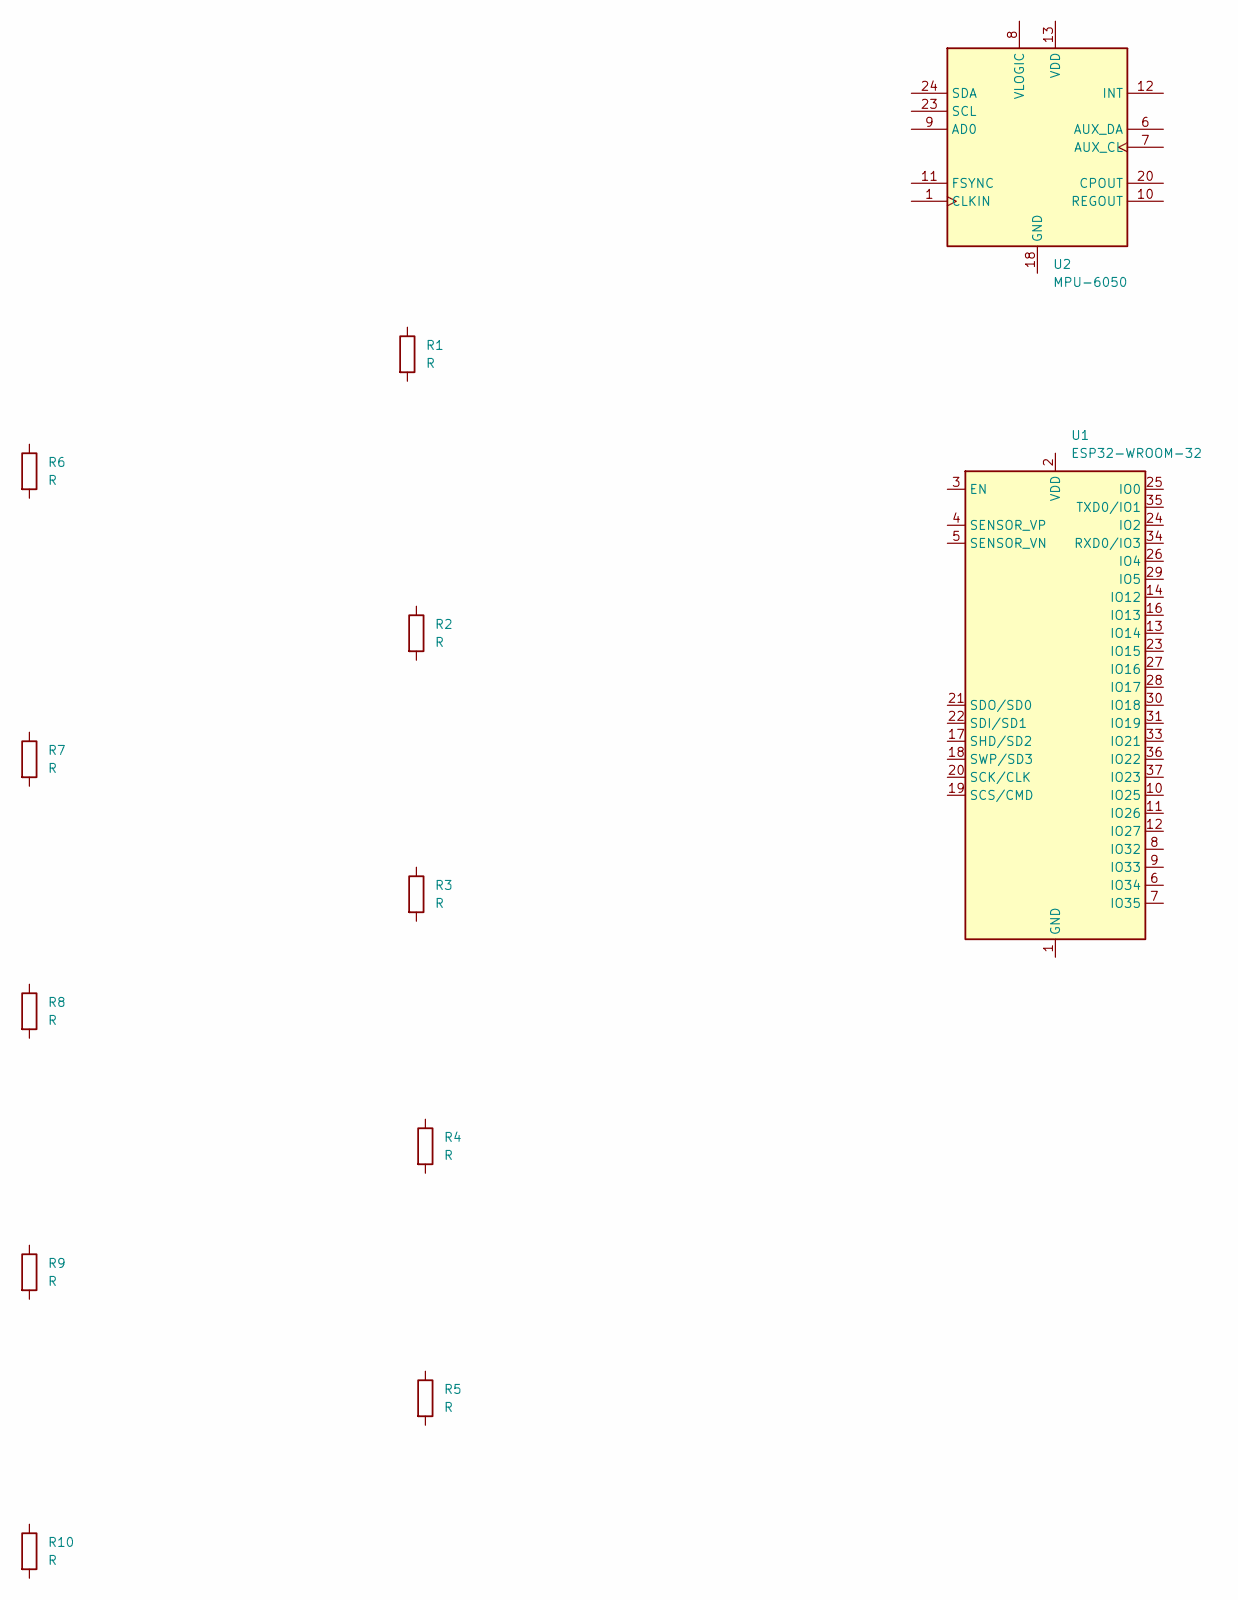
[picture p25: schematic CYNEXIS_Phase1_ControlGlove.kicad_sch]

Parts:
R1, R2, R3, R4, R5, R6, R7, R8, R9, R10: R
U1: ESP32-WROOM-32
U2: MPU-6050; InvenSense_QFN-24_4x4mm_P0.5mm

Connections:
unnamed: U1.1 (GND), U1.15 (GND), U1.38 (GND), U1.39 (GND)
