MohammedAshikM3003/Cynexis/Firmware/ControlGlove/control_glove/cynexis_mac.h

#pragma once
#include <stdint.h>

static const uint8_t MAC_ROBOT[6] = {
    0x04, 0xB2, 0x47, 0x82, 0x38, 0xFC
};

static const uint8_t MAC_GLOVE_CONTROL[6] = {
    0x04, 0xB2, 0x47, 0x82, 0x59, 0x18
};

static const uint8_t MAC_GLOVE_STATUS[6] = {
    0x28, 0x05, 0xA5, 0xE2, 0x85, 0xB8
};
