MohammedAshikM3003/Cynexis/Testing/ir_sensor_1_test/ir_sensor_1_test.ino

/*
 * ============================================================
 * CYNEXIS — Dedicated IR Sensor #1 Isolated Test Sketch
 * ------------------------------------------------------------
 * Pin Assignments:
 *   - IR Sensor #1 OUT : GPIO 23 (INPUT)
 *   - VCC              : 3.3V
 *   - GND              : GND
 * Baud Rate: 115200
 * ============================================================
 */

#include <Arduino.h>

#define PIN_IR_SENSOR_1 23

void setup() {
    Serial.begin(115200);
    delay(1000);

    Serial.println("\n==================================================");
    Serial.println(" CYNEXIS — IR SENSOR #1 TEST ");
    Serial.println("==================================================");
    Serial.println("GPIO: 23");
    Serial.println("VCC : 3.3V");
    Serial.println("Baud Rate: 115200");
    Serial.println("--------------------------------------------------\n");

    pinMode(PIN_IR_SENSOR_1, INPUT);
    delay(100);
}

void loop() {
    int val = digitalRead(PIN_IR_SENSOR_1);

    if (val == LOW) {
        Serial.println("IR: LOW  | OBJECT: DETECTED");
    } else {
        Serial.println("IR: HIGH | OBJECT: NOT DETECTED");
    }

    delay(200); // Sample rate: ~5 Hz
}
