MohammedAshikM3003/Cynexis/(commit log)

2026-08-03 Initial commit: CYNEXIS Day 0 environment setup
    - Add complete project folder structure
    - Add ESP-NOW protocol (cynexis_protocol.h, cynexis_mac.h)
    - Add Control Glove firmware (control_glove.ino)
    - Add Robot ESP32 firmware (robot_esp32.ino)
    - Add Status Glove firmware (status_glove.ino)
    - Add Development Notebook (CYNEXIS_Development_Notebook.md)
    - Add Master System Prompt v1.1
    - Add Wokwi Phase 1 simulation (phase1_test.ino)
    - Add .gitignore and VS Code extensions config
    - Add comprehensive README.md
    Day 0 complete. Hardware pending delivery.
2026-08-04 spec: CYNEXIS v2.0 - Master Specification, System Prompt V2, CHANGELOG, new BOM dirs
    - Created CYNEXIS_MASTER_SPECIFICATION.md (single source of truth)
    - Updated CYNEXIS_MASTER_SYSTEM_PROMPT.md to V2.0 (Architect Edition)
    - Created CHANGELOG.md with full history from Day 0
    - Updated Hardware_Shopping_Guide.md with user corrections
    - Created BOM/, CAD/, PCB/, Database/ directories
    - Architecture locked: CYNEXIS OS, touchscreen, DS3218, ChromaDB, INMP441 added
    - Removed: MongoDB, MQTT, TensorFlow, hologram, old voice control
2026-08-04 spec: v2.1 - Apply 6 architectural corrections
    1. Voice: standalone mode removed, AI-assisted interaction retained
    2. Power: LM2596 #1 corrected 7.5V -> 6.5V for DS3218 servos
    3. Status glove: split into Stage A (ESP32+touch+vibration) and Stage B (mic+amp+speaker)
    4. Camera: USB transport path made explicit (USB->OpenCV->YOLO->WebSocket->Robot)
    5. Thermal: added fan, vents, airflow, servo monitoring requirements
    6. Dirs: Logs/, Assets/, UI/ created
2026-08-04 spec: v2.1 - version fix, section numbering, INA219, state machine, packet defs
    - Header: v2.0 -> v2.1, Status: Active added
    - Fixed duplicate section numbers (10/11/10/11/12 -> 10-16)
    - RB21: INA219 current+voltage sensor added to robot BOM
    - Section 12: System State Machine (7 states, EMERGENCY=HW reset only)
    - Section 13: Packet definitions (Control 24B@50Hz, Status 20B@10Hz)
    - CHANGELOG: v2.1 entry added
    - Specification frozen for build
2026-08-04 docs: KNOWN_ISSUES.md + Phase1_Checklist.md
    - KNOWN_ISSUES.md: structured issue log with template (Date, ID, Component, Cause, Solution, Status)
    - Phase1_Checklist.md: full 9-step Phase 1 procedure (tools, software, flash, MAC, ESP-NOW, MPU6050, flex, calibration, integration)
    - Ready for hardware arrival
2026-08-04 phase1: Wokwi circuit + wiring guide + GPIO39 for Pinky
    - diagram.json: full circuit (ESP32 + MPU6050 + 5 flex pots + LED)
    - control_glove_sim.ino: simulation firmware (flex ADC + MPU6050 + gestures)
    - wokwi.toml: points to control_glove_sim.ino
    - control_glove.ino: GPIO25 -> GPIO39 for Pinky (ADC1, WiFi-safe)
    - Schematics/Phase1_ControlGlove_Wiring.md: full wiring table + test points
    - GPIO decision logged: GPIO39 avoids ADC2/WiFi conflict
    [control_glove.ino, control_glove_sim.ino]
2026-08-04 kicad: Phase1 ControlGlove project structure + guide
2026-08-12 voice of cynexis
    [CYNEXIS_Phase1_ControlGlove.kicad_pcb, CYNEXIS_Phase1_ControlGlove.kicad_sch]
2026-09-17 arm app
2026-09-19 arm app st 1
2026-09-23 5 MG996R servor motor tested
2026-09-24 7 servo motor test
2026-09-24 servo test 1 pass
2026-10-05 ultrasonic sensor
